ib134866/EleksTube/EleksTube_Wifi/20190106_133145.jpg

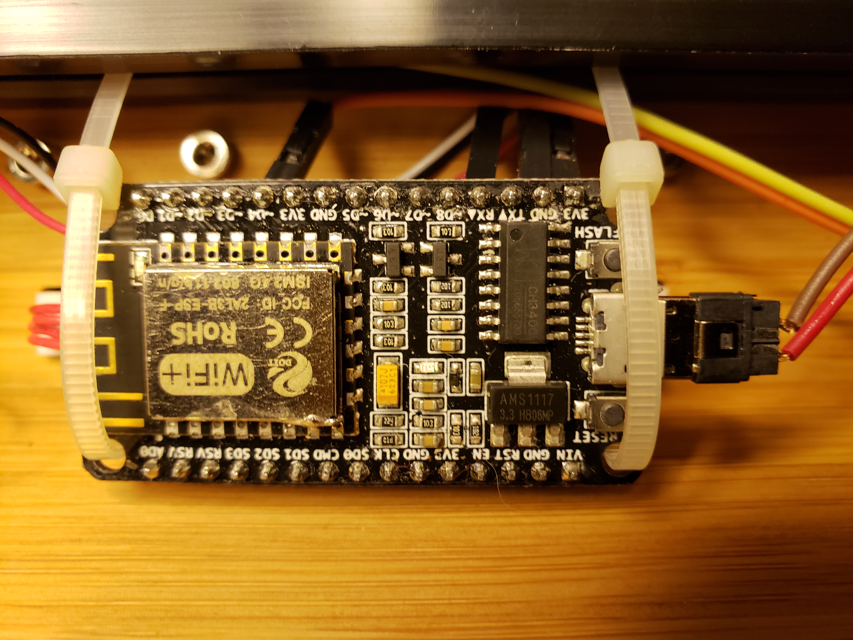
EleksTube_Wifi/20190106_133145.jpg
